kristosb/bolidJS/pcb/BOM/micro_stepper.png

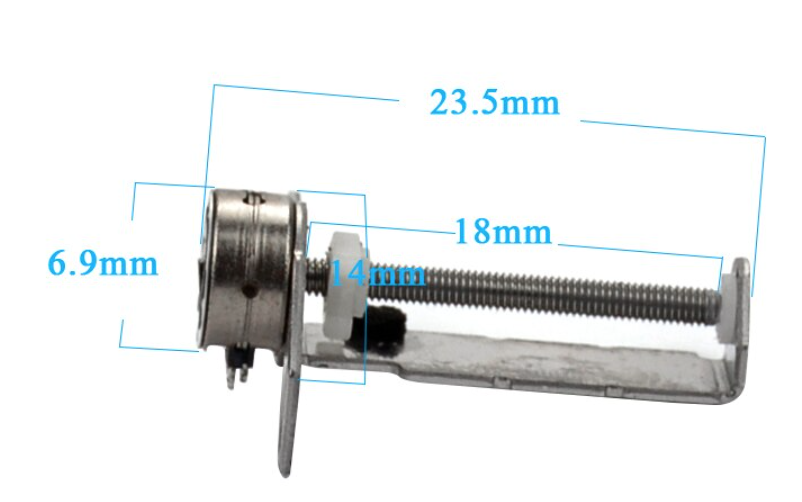
pcb/BOM/micro_stepper.png
