kristosb/bolidJS/pcb/BOM/wheels.png

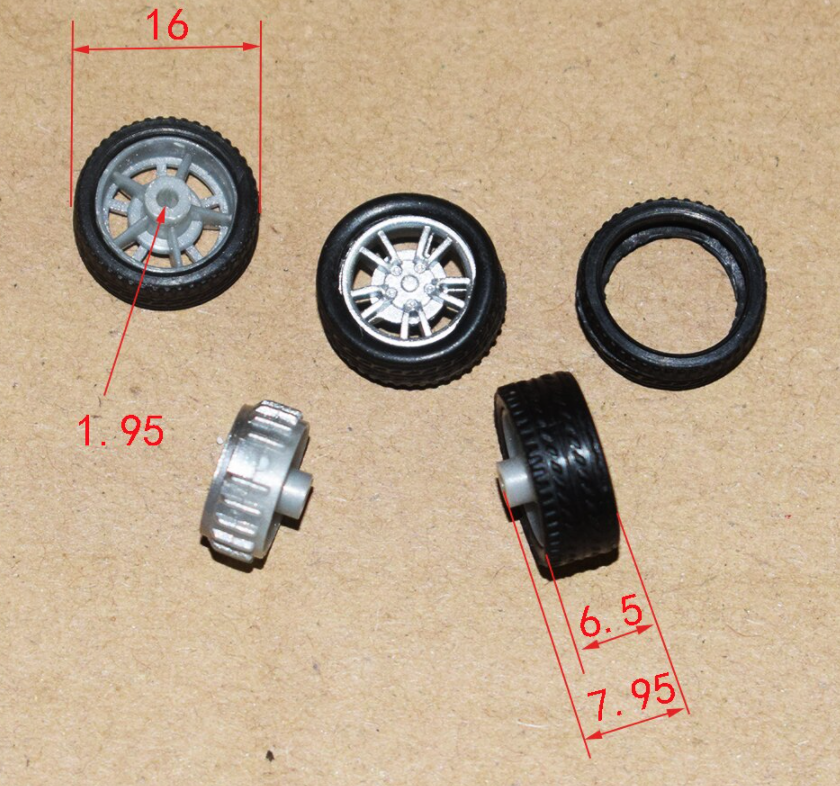
pcb/BOM/wheels.png
