kristosb/bolidJS/pcb/BOM/m20_motor.png

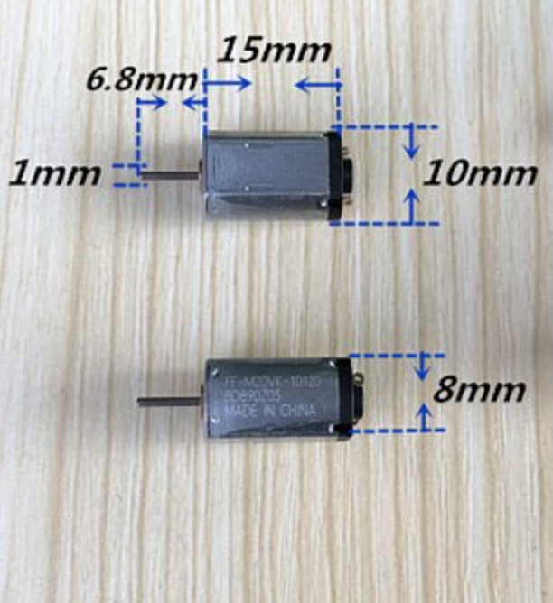
pcb/BOM/m20_motor.png
