kristosb/bolidJS/pcb/BOM/pogopins.png

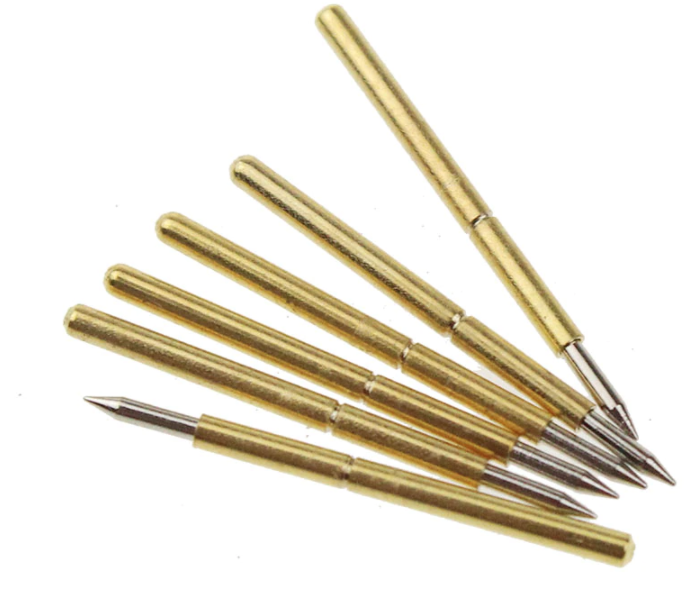
pcb/BOM/pogopins.png
