kristosb/bolidJS/pcb/BOM/steering.jpg

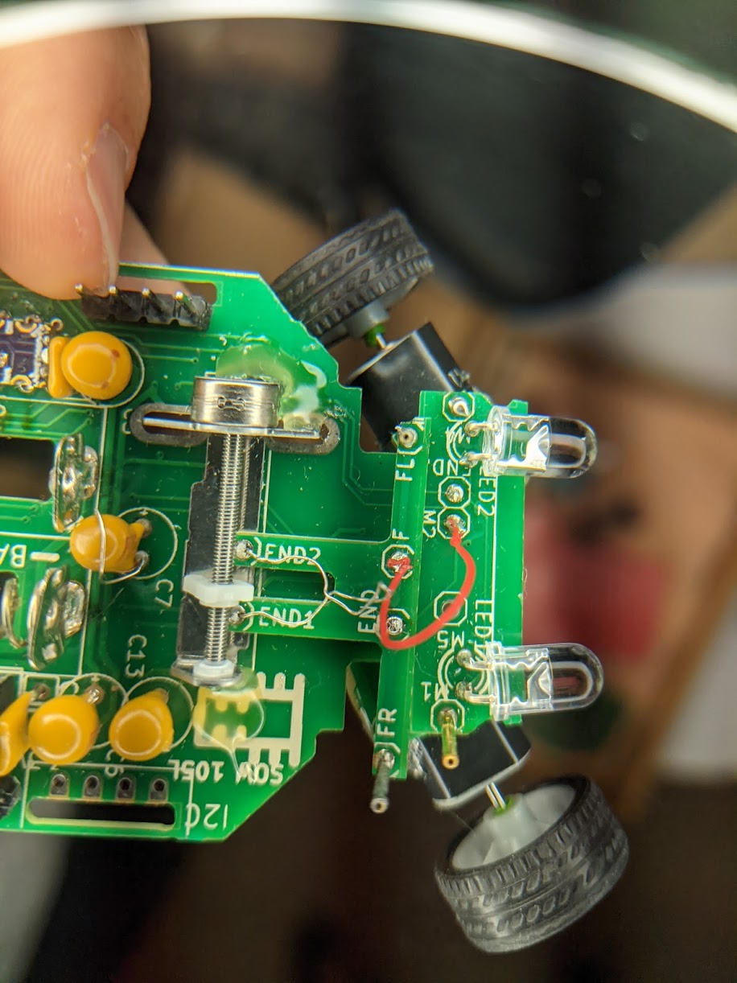
pcb/BOM/steering.jpg
