kristosb/bolidJS/pcb/bolidjs/gerber/bolidJs_schematic.pdf

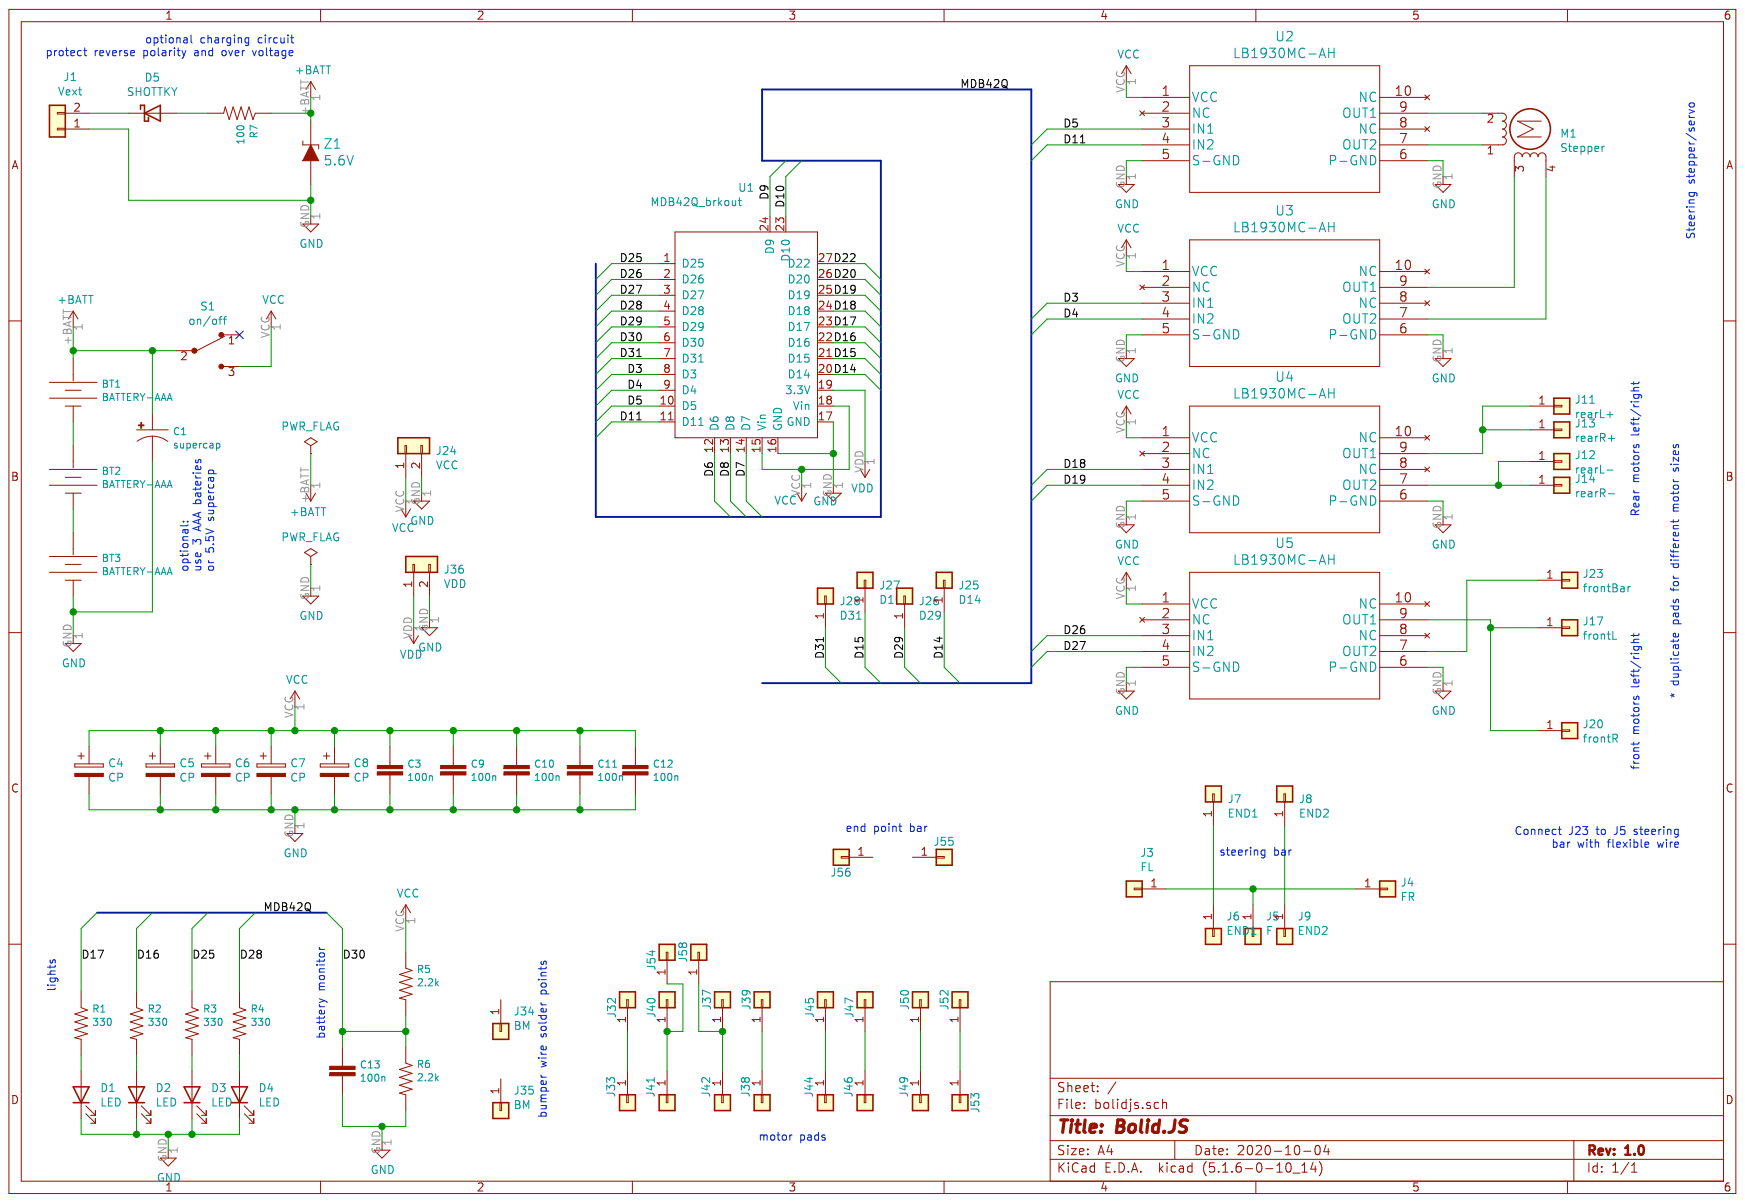
[picture p6: page 1]
