kristosb/bolidJS/pcb/bolidjs/gerber/bolidJs_layout_all.pdf

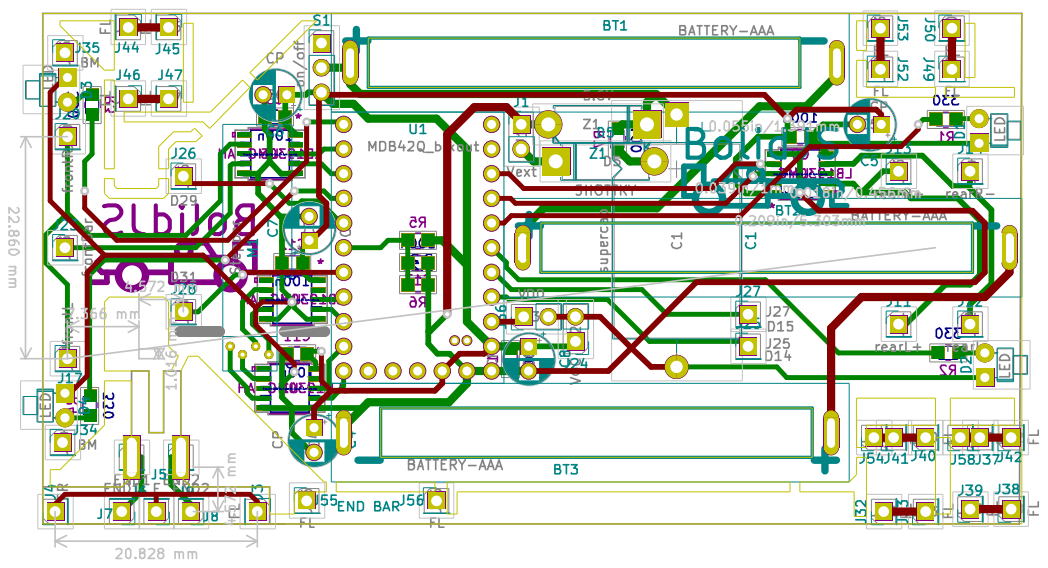
[picture p7: page 1]
