kristosb/bolidJS/pcb/bolidjs/bolidjs.sch

## KiCad design pcb/bolidjs/bolidjs.sch (2020-10-29, an earlier design)

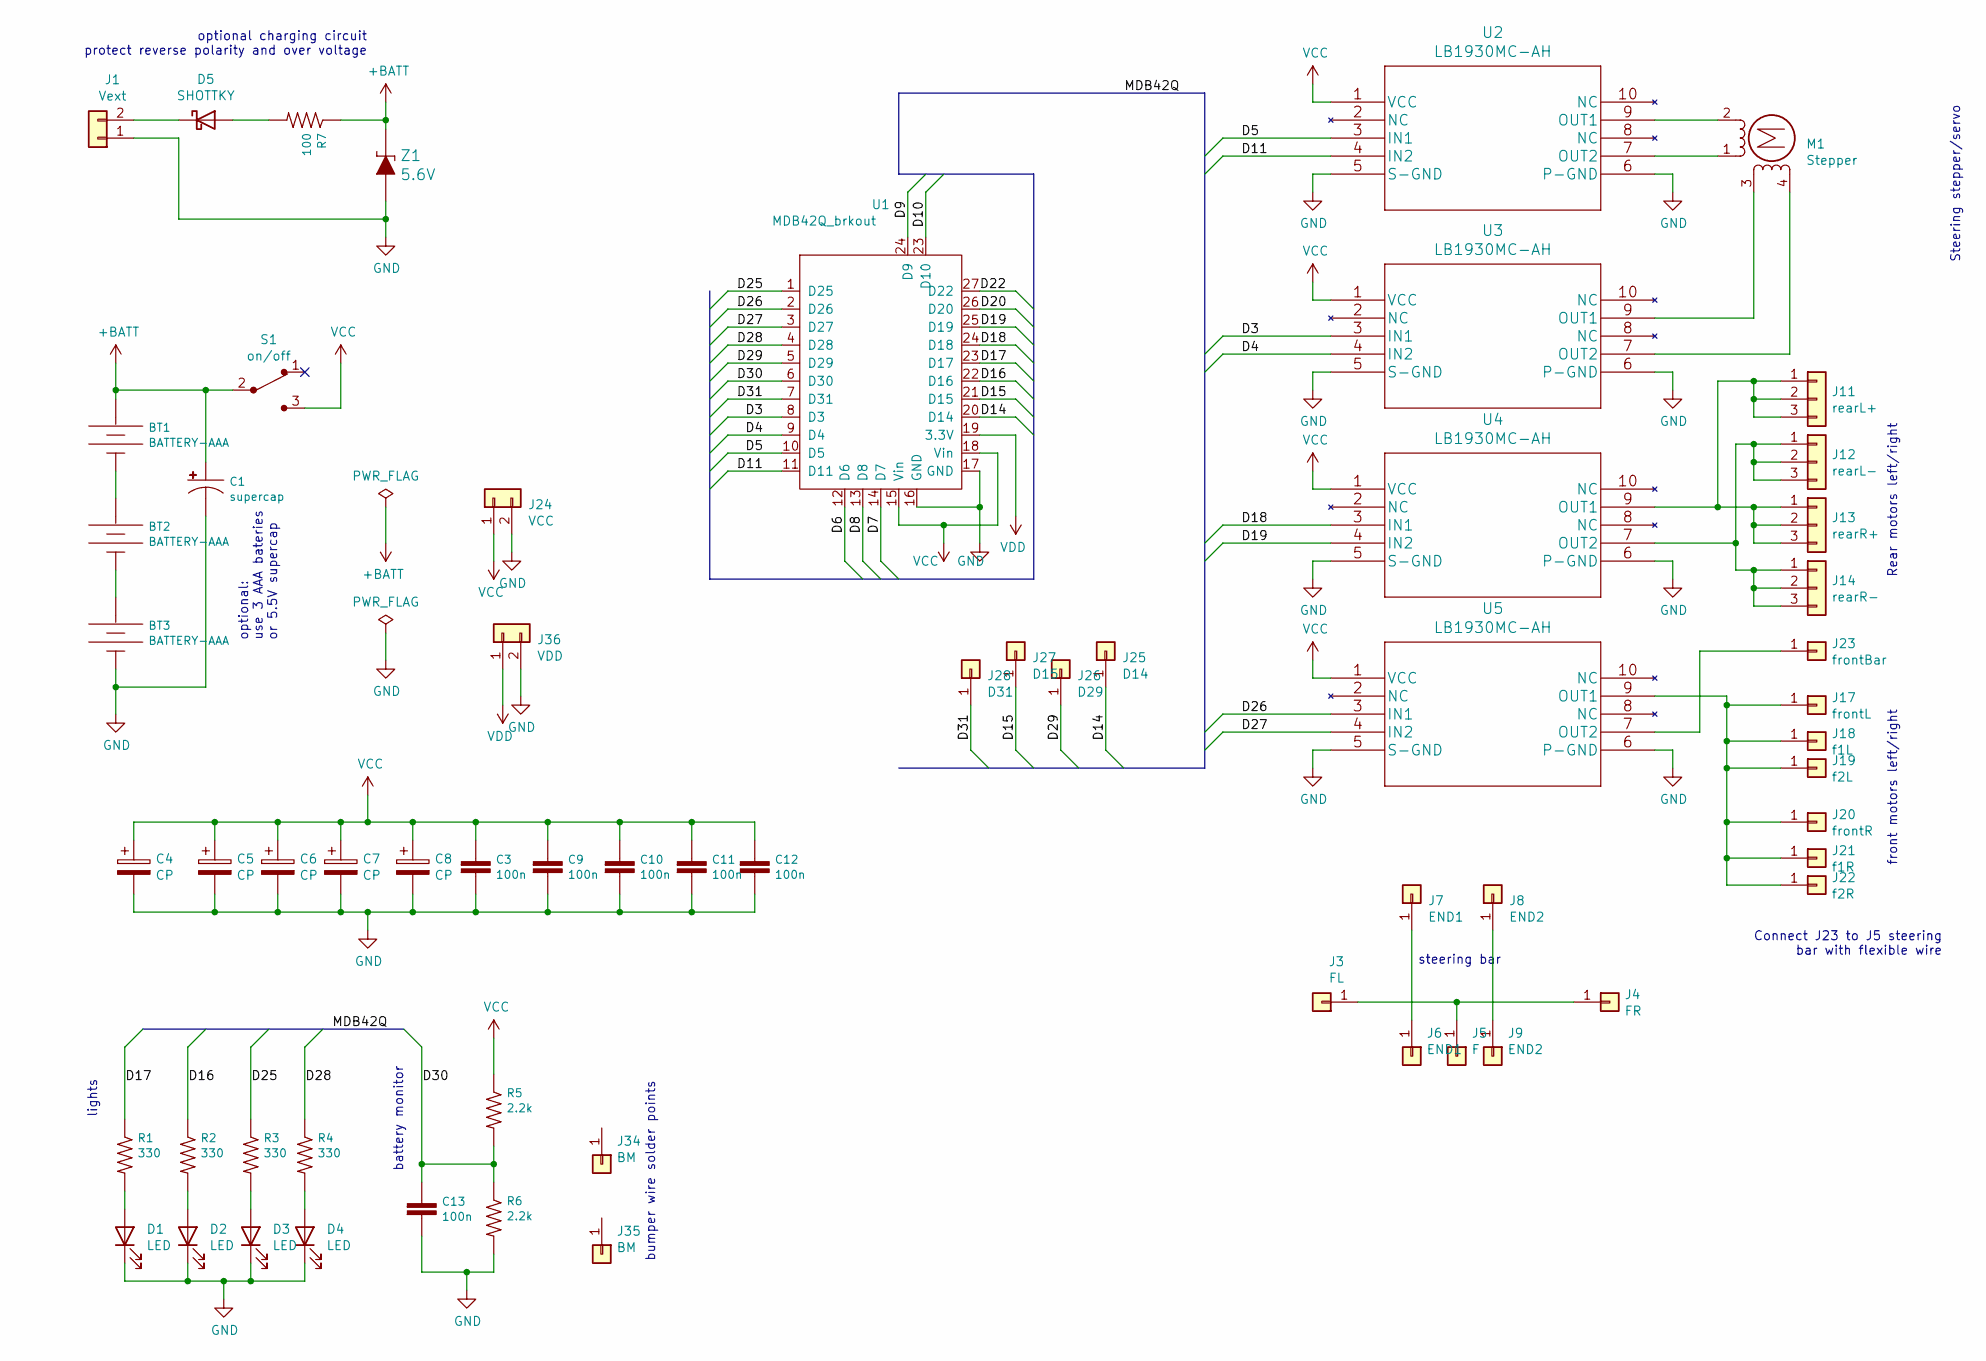
[picture p11: schematic bolidjs.sch]

Parts:
BT1, BT2, BT3: BATTERY-AAA; BatterySlot_AAA
C1: supercap; super_cap
C3, C9, C10, C11, C12, C13: 100n; 0805
C4, C5, C6, C7, C8: CP; CP_Radial_D5.0mm_P2.50mm
D1, D2, D3, D4: LED; LED_D1.8mm_W1.8mm_H2.4mm_Horizontal_O1.27mm_Z4.9mm
D5: SHOTTKY; Schottkey_D_5W_P10.16mm_Horizontal
J1: Vext; PinHeader_1x02_P2.54mm_Vertical
J3: FL; PinHeader_1x01_P2.54mm_Vertical
J4: FR; PinHeader_1x01_P2.54mm_Vertical
J5: F; PinHeader_1x01_P2.54mm_Vertical
J6, J7: END1; PinHeader_1x01_P2.54mm_Vertical
J8, J9: END2; PinHeader_1x01_P2.54mm_Vertical
J11: rearL+; PinHeader_1x03_P2.54mm_Vertical
J12: rearL-; PinHeader_1x03_P2.54mm_Vertical
J13: rearR+; PinHeader_1x03_P2.54mm_Vertical
J14: rearR-; PinHeader_1x03_P2.54mm_Vertical
J17: frontL; PinHeader_1x01_P2.54mm_Vertical
J18: f1L; PinHeader_1x01_P2.54mm_Vertical
J19: f2L; PinHeader_1x01_P2.54mm_Vertical
J20: frontR; PinHeader_1x01_P2.54mm_Vertical
J21: f1R; PinHeader_1x01_P2.54mm_Vertical
J22: f2R; PinHeader_1x01_P2.54mm_Vertical
J23: frontBar; PinHeader_1x01_P2.54mm_Vertical
J24: VCC; PinHeader_1x02_P2.54mm_Vertical
J25: D14; PinHeader_1x01_P2.54mm_Vertical
J26: D29; PinHeader_1x01_P2.54mm_Vertical
J27: D15; PinHeader_1x01_P2.54mm_Vertical
J28: D31; PinHeader_1x01_P2.54mm_Vertical
J34, J35: BM; PinHeader_1x01_P2.54mm_Vertical
J36: VDD; PinHeader_1x02_P2.54mm_Vertical
M1: Stepper; screwSliderStepper
R1, R2, R3, R4: 330; 0805
R5, R6: 2.2k; 0805
R7: 100; 0805
S1: on/off; PinHeader_1x03_P2.54mm_Vertical; MPN ATE1D-2M3-10-Z; Digi-Key_PN 563-1157-ND
U1: MDB42Q_brkout; MDBQ42Q_brkout
U2, U3, U4, U5: LB1930MC-AH
Z1: 5.6V; zener_D_5W_P10.16mm_Horizontal; MPN 1N5231BTR; Digi-Key_PN 1N5231BFSCT-ND

Connections:
+BATT: BT1.PWR@ (+), C1.+, R7.1, S1.2 (Com), Z1.K
D3: U1.8 (D3), U3.3 (IN1)
D4: U1.9 (D4), U3.4 (IN2)
D5: U1.10 (D5), U2.3 (IN1)
D6: U1.12 (D6)
D7: U1.14 (D7)
D8: U1.13 (D8)
D9: U1.24 (D18)
D10: U1.23 (D10)
D11: U1.11 (D11), U2.4 (IN2)
D14: J25.1, U1.20 (D14)
D15: J27.1, U1.21 (D15)
D16: R2.1, U1.22 (D16)
D17: R1.1, U1.23 (D10)
D18: U1.24 (D18), U4.3 (IN1)
D19: U1.25 (D19), U4.4 (IN2)
D20: U1.26 (D20)
D22: U1.27 (D22)
D25: R3.1, U1.1 (D25)
D26: U1.2 (D26), U5.3 (IN1)
D27: U1.3 (D27), U5.4 (IN2)
D28: R4.1, U1.4 (D28)
D29: J26.1, U1.5 (D29)
D30: C13.1, R5.2, R6.1, U1.6 (D30)
D31: J28.1, U1.7 (D31)
GND: BT3.GND@ (-), C1.-, C3.2, C4.2, C5.2, C6.2, C7.2, C8.2, C9.2, C10.2, C11.2, C12.2, C13.2, D1.1 (K), D2.1 (K), D3.1 (K), D4.1 (K), J1.1, J24.2, J36.2, R6.2, U1.16 (GND), U1.17 (GND), U2.5 (S-GND), U2.6 (P-GND), U3.5 (S-GND), U3.6 (P-GND), U4.5 (S-GND), U4.6 (P-GND), U5.5 (S-GND), U5.6 (P-GND), Z1.A
unnamed: BT1.GND@ (-), BT2.PWR@ (+)
unnamed: BT2.GND@ (-), BT3.PWR@ (+)
unnamed: D1.2 (A), R1.2
unnamed: D2.2 (A), R2.2
unnamed: D3.2 (A), R3.2
unnamed: D4.2 (A), R4.2
unnamed: D5.1 (K), J1.2
unnamed: D5.2 (A), R7.2
unnamed: J3.1, J4.1, J5.1
unnamed: J6.1, J7.1
unnamed: J8.1, J9.1
unnamed: J11.1, J11.2, J11.3, J13.1, J13.2, J13.3, U4.9 (OUT1)
unnamed: J12.1, J12.2, J12.3, J14.1, J14.2, J14.3, U4.7 (OUT2)
unnamed: J17.1, J18.1, J19.1, J20.1, J21.1, J22.1, U5.9 (OUT1)
unnamed: J23.1, U5.7 (OUT2)
unnamed: M1.1, U2.7 (OUT2)
unnamed: M1.2 (-), U2.9 (OUT1)
unnamed: M1.3, U3.9 (OUT1)
unnamed: M1.4, U3.7 (OUT2)
VCC: C3.1, C4.1, C5.1, C6.1, C7.1, C8.1, C9.1, C10.1, C11.1, C12.1, J24.1, R5.1, S1.3, U1.15 (Vin), U1.18 (Vin), U2.1 (VCC), U3.1 (VCC), U4.1 (VCC), U5.1 (VCC)
VDD: J36.1, U1.19 (3.3V)

Notes on the sheet:
Steering stepper/servo
Rear motors left/right
front motors left/right
steering bar
Connect J23 to J5 steering bar with flexible wire
optional charging circuit protect reverse polarity and over voltage
lights
battery monitor
optional: use 3 AAA bateries or 5.5V supercap
bumper wire solder points
