kristosb/bolidJS/(commit log)

2020-10-21 adding pdf for schematic and layout
    [bolidjs.sch]
2020-10-21 steering pic
2020-10-26 added steering option and wheel pads
    [bolidjs-B_Cu.gbr, bolidjs-B_Mask.gbr, bolidjs-B_Paste.gbr, bolidjs-B_SilkS.gbr, bolidjs-Edge_Cuts.gbr, bolidjs-F_Cu.gbr, bolidjs-F_Mask.gbr, bolidjs-F_Paste.gbr]
2020-10-29 removed options for motor sizes
    [bolidjs-B_Cu.gbr, bolidjs-B_Mask.gbr, bolidjs-B_Paste.gbr, bolidjs-B_SilkS.gbr, bolidjs-Edge_Cuts.gbr, bolidjs-F_Cu.gbr, bolidjs-F_Mask.gbr, bolidjs-F_Paste.gbr]
2020-10-29 steering bar is ticker
    [bolidjs-B_Cu.gbr, bolidjs-B_Mask.gbr, bolidjs-B_Paste.gbr, bolidjs-B_SilkS.gbr, bolidjs-Edge_Cuts.gbr, bolidjs-F_Cu.gbr, bolidjs-F_Mask.gbr, bolidjs-F_Paste.gbr]
2020-11-02 minor change
    [bolidjs-B_Cu.gbr, bolidjs-B_Mask.gbr, bolidjs-B_Paste.gbr, bolidjs-B_SilkS.gbr, bolidjs-Edge_Cuts.gbr, bolidjs-F_Cu.gbr, bolidjs-F_Mask.gbr, bolidjs-F_Paste.gbr]
2020-11-03 gerber format
    [bolidjs-B_Cu.gbr, bolidjs-B_Mask.gbr, bolidjs-B_Paste.gbr, bolidjs-B_SilkS.gbr, bolidjs-Edge_Cuts.gbr, bolidjs-F_Cu.gbr, bolidjs-F_Mask.gbr, bolidjs-F_Paste.gbr]
2021-02-08 added bt communication
    [bolidjs.csv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]
2021-02-09 calibration routine experiments
2021-02-17 added offset for steering
2021-02-19 added breaking motors through fast decay
2021-02-23 heartbeat flashing diodes on disconnect
